AcquaV/air-quality-sensor-station/Hardware/production/bom.csv

Designator | Footprint | Quantity | Value | LCSC Part #
3V3, 5V, CLK, DATA, GND | TestPoint_Pad_1.0x1.0mm | 5 | TestPoint_Alt
BOOT | C55200589_SW-SMD_4P-L4_2-W3_4-P2_15-LS5_2 | 1 | BOOT | C55200589
C1, C12, C14, C9 | C1713_C0805 | 4 | 10uF | C1713
C10, C11, C15, C16, C17, C3, C4, C5, C6, C7, C8 | C1525_C0402 | 11 | 100nF | C1525
C13, C2 | C1592_C0603 | 2 | 1uF | C1592
CN1 | C225129_CONN-SMD_A1257WR-S-6P | 1 | A1257WR-S-6P | C225129
CN2 | C157914_CONN-TH_S8B-XH-A-LF-SN | 1 | TFT DISPLAY | C157914
CN3 | C157928_CONN-TH_S3B-XH-A-LF-SN | 1 | CAPACITIVE BUTTON | C157928
D1 | C7519_SOT-23-6_L2_9-W1_6-P0_95-LS2_8-BL | 1 | USBLC6-2SC6 | C7519
D2 | C169426_SOD-123F_L2_8-W1_8-LS3_7-RD | 1 | SMF5.0A | C169426
F1 | C20996_F1812 | 1 | 0.75A | C20996
LED1 | C2293_LED0805-R-RD | 1 | XL-0805QBC | C2293
Q1 | C15127_SOT-23_L2_9-W1_3-P1_90-LS2_4-BR | 1 | AO3401A | C15127
R1, R11, R2 | C17902_R1206 | 3 | 10K | C17902
R10, R12, R13, R4 | C14675_R0603 | 4 | 100k | C14675
R5, R6, R9 | C4190_R0603 | 3 | 2.2K | C4190
R7, R8 | C23186_R0603 | 2 | 5.1K | C23186
RST | C55200589_SW-SMD_4P-L4_2-W3_4-P2_15-LS5_2 | 1 | RESET | C55200589
U1 | C22391138_LGA-10_L2_0-W2_0-P0_50-TL_BMP580 | 1 | BMP580 | C22391138
U2 | C3037696_LGA-20_L10_1-W10_1-P1_25-TL | 1 | SCD40-D-R1 | C3037696
U3 | C3659325_DFN-6_L2_4-W2_4-P0_80-TL-EP | 1 | SGP41-D-R4 | C3659325
U6 | C2913197_WIFIM-SMD_ESP32-S3-WROOM-1-N8 | 1 | ESP32-S3-WROOM-1-N4 | C2913197
U7 | C435835_SOT-223-4_L6_5-W3_5-P2_30-LS7_0-BR | 1 | LDL1117S33R | C435835
USB1 | C5338274_USB-C-SMD_HYCW395-USBC16-085B | 1 | HYCW395-USBC16-085B | C5338274
