AcquaV/air-quality-sensor-station/Hardware/Air_Quality.kicad_pcb

## KiCad design Hardware/Air_Quality.kicad_pcb (2026-11-13)

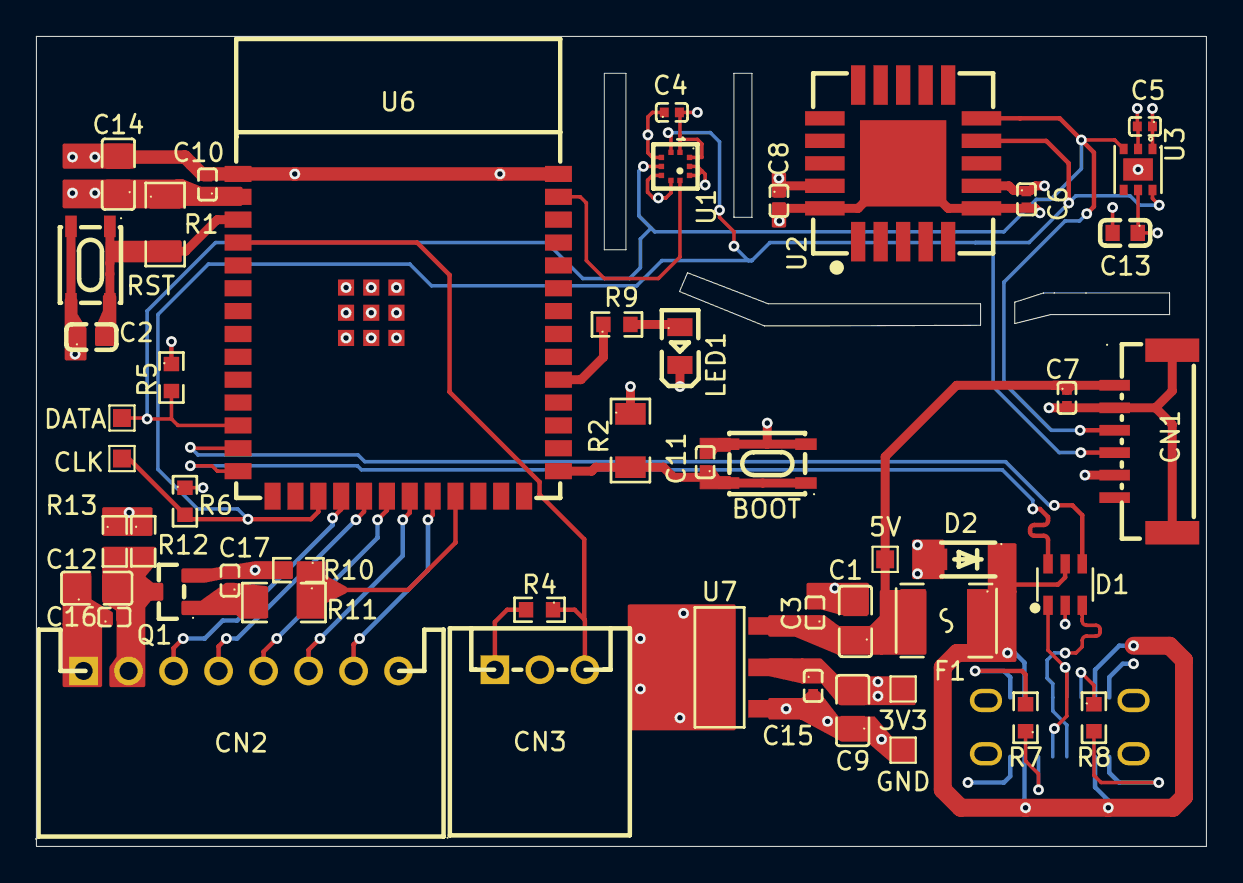
[picture p1: board Air_Quality.kicad_pcb from above]

Board: 4 copper layers, 65.0 x 45.0 mm, 50 parts (1 on the bottom side), 26 nets.

Parts:
3V3, 5V: TestPoint_Alt; TestPoint_Pad_1.0x1.0mm
BOOT: BOOT; C55200589_SW-SMD_4P-L4_2-W3_4-P2_15-LS5_2
C1, C9, C12, C14: 10uF; C1713_C0805
C2, C13: 1uF; C1592_C0603
C3, C4, C5, C6, C7, C8, C10, C11, C15, C16, C17: 100nF; C1525_C0402
CLK: TestPoint_Alt; TestPoint_Pad_1.0x1.0mm
CN1: A1257WR-S-6P; C225129_CONN-SMD_A1257WR-S-6P
CN2: TFT DISPLAY; C157914_CONN-TH_S8B-XH-A-LF-SN
CN3: CAPACITIVE BUTTON; C157928_CONN-TH_S3B-XH-A-LF-SN
D1: USBLC6-2SC6; C7519_SOT-23-6_L2_9-W1_6-P0_95-LS2_8-BL
D2: SMF5.0A; C169426_SOD-123F_L2_8-W1_8-LS3_7-RD
DATA: TestPoint_Alt; TestPoint_Pad_1.0x1.0mm
F1: 0.75A; C20996_F1812
GND: TestPoint_Alt; TestPoint_Pad_1.0x1.0mm
LED1: XL-0805QBC; C2293_LED0805-R-RD
Q1: AO3401A; C15127_SOT-23_L2_9-W1_3-P1_90-LS2_4-BR
R1, R2, R11: 10K; C17902_R1206
R4, R10, R12, R13: 100k; C14675_R0603
R5, R6, R9: 2.2K; C4190_R0603
R7, R8: 5.1K; C23186_R0603
RST: RESET; C55200589_SW-SMD_4P-L4_2-W3_4-P2_15-LS5_2
U1: BMP580; C22391138_LGA-10_L2_0-W2_0-P0_50-TL_BMP580
U2: SCD40-D-R1; C3037696_LGA-20_L10_1-W10_1-P1_25-TL
U3: SGP41-D-R4; C3659325_DFN-6_L2_4-W2_4-P0_80-TL-EP
U6: ESP32-S3-WROOM-1-N4; C2913197_WIFIM-SMD_ESP32-S3-WROOM-1-N8
U7: LDL1117S33R; C435835_SOT-223-4_L6_5-W3_5-P2_30-LS7_0-BR
USB1: HYCW395-USBC16-085B; C5338274_USB-C-SMD_HYCW395-USBC16-085B

Connections:
3V3: 3V3.1 (1_1), C4.2, C5.1, C6.1, C8.1, C9.2, C10.1, C13.1, C14.1, C15.1, C17.2, CN3.2 (3V3), Q1.2 (S), R1.1, R2.1, R5.1, R6.1, R10.2, U1.1 (VDDIO), U1.5 (SDO), U1.6 (CSB), U1.10 (VDD), U2.7 (VDD), U2.19 (VDDH), U3.1 (VDD), U3.5 (VDDH), U6.2 (3V3), U7.2 (VOUT), U7.4 (VOUT)
5V: 5V.1 (1_1), C1.1, C3.1, C7.1, CN1.1 (VCC), F1.2, U7.3 (VIN)
CS_D: CN2.7 (CS), U6.22 (IO14)
DC_D: CN2.6 (DC), U6.21 (IO13)
D_ENABLE: R10.1, R11.1, U6.23 (IO21)
GND: BOOT.3, BOOT.4, C1.2, C2.1, C3.2, C4.1, C5.2, C6.2, C7.2, C8.2, C9.1, C10.2, C11.2, C12.1, C13.2, C14.2, C15.2, C16.1, CN1.2 (GND), CN1.5 (SEL), CN1.7, CN1.8, CN2.1 (GND), CN3.1 (GND), D1.2, D2.2, GND.1 (1_1), LED1.2 (K), R4.2, R7.2, R8.2, R12.1, R13.1, RST.3, RST.4, U1.3 (VSS), U1.8 (VSS), U1.9 (VSS), U2.6 (GND), U2.20 (GND), U2.21 (GND), U3.2 (VSS), U3.7 (EP), U6.1 (GND), U6.40 (GND), U6.41 (GND), U7.1 (GND), USB1.1 (EH), USB1.A1 (GND), USB1.A12 (GND), USB1.B1 (GND), USB1.B12 (GND)
I2C_CLK: CLK.1 (1_1), CN1.4 (SCL), R6.2, U1.2 (SCK), U2.9 (SCL), U3.6 (SCL), U6.17 (IO9)
I2C_DATA: CN1.3 (SDA), DATA.1 (1_1), R5.2, U1.4 (SDI), U2.10 (SDA), U3.3 (SDA), U6.12 (IO8)
INT_PRESS: U1.7 (INT), U6.39 (IO1)
unnamed: C12.2, C16.2, CN2.2 (VCC), Q1.3 (D), R12.2, R13.2
unnamed: D1.5, D2.1, F1.1, USB1.A4 (VBUS), USB1.A9 (VBUS), USB1.B4 (VBUS), USB1.B9 (VBUS)
unnamed: LED1.1 (A), R9.2
unnamed: C17.1, Q1.1 (G), R11.2
unnamed: C2.2, R1.2, RST.1, RST.2, U6.3 (EN)
unnamed: BOOT.1, BOOT.2, C11.1, R2.2, U6.27 (IO0)
unnamed: R9.1, U6.31 (IO38)
unnamed: R8.1, USB1.A5 (CC1)
unnamed: R7.1, USB1.B5 (CC2)
unnamed: D1.3, USB1.A7 (Dn1), USB1.B7 (Dn2)
unnamed: D1.1, USB1.A6 (Dp1), USB1.B6 (Dp2)
RST_D: CN2.5 (RST), U6.20 (IO12)
SCL_D: CN2.3 (SCL), U6.18 (IO10)
SDA_D: CN2.4 (SDA), U6.19 (IO11)
TOUCH: CN3.3 (TOUCH), R4.1, U6.4 (IO4)
USB_DATA+: D1.6, U6.14 (IO20)
USB_DATA-: D1.4, U6.13 (IO19)
