AcquaV/air-quality-sensor-station/(commit log)

2026-10-12 Started pcb
    [Air_Quality.kicad_pcb, Air_Quality.kicad_sch, power.kicad_sch, sensor.kicad_sch]
2026-10-12 Finished schematics
    [Air_Quality.kicad_sch, sensor.kicad_sch]
2026-10-13 Added optional screen
    [Air_Quality.kicad_sch]
2026-10-13 Changed LDO, defined GPIO pins
    [Air_Quality.kicad_sch, power.kicad_sch]
2026-10-31 Prova 1
    [Air_Quality.kicad_pcb]
2026-11-01 Routing finished
    [Air_Quality.csv, Air_Quality.kicad_pcb, Air_Quality.kicad_sch, power.kicad_sch, sensor.kicad_sch]
2026-11-01 Little thing
    [Air_Quality.kicad_pcb]
2026-11-03 Added data line and power security
    [Air_Quality.kicad_pcb, Air_Quality.kicad_sch, power.kicad_sch]
2026-11-05 changed some specs
    [Air_Quality.kicad_pcb, Air_Quality.kicad_sch, display.kicad_sch]
2026-11-08 Switched display, added button
    [Air_Quality.kicad_pcb, Air_Quality.kicad_sch, display.kicad_sch]
2026-11-08 new routing
    [Air_Quality.kicad_pcb]
2026-11-08 Added slot for heat isolation
    [Air_Quality.kicad_pcb]
2026-11-13 Finished board, lacks monting hole, text
    [Air_Quality.kicad_pcb, bom.csv, designators.csv, positions.csv]
